galileosky/Arduino_uSDX_Pico_FFT_Proj/(commit log)

2026-02-16 Correcting memories load after Pro Mini setup switching relays Correcting S-Meters when changing memories
    [Arduino_uSDX_Pico_FFT.ino, Eeprom.cpp, display_tft.cpp, hmi.cpp, monitor.cpp, uSDR.cpp, uSDR.h]
2026-02-16 Correcting reading memories Changing version to month, day and year
    [uSDR.h]
2026-02-16 Improving relays connection
